freetronics/WiFiShield/README.markdown

Freetronics WiFi Shield

PCB fab stackup: 2-layer FR-4, 0.8mm thick. 0.8mm thickness is important to keep the waveguide impedence in the right ballpark. 

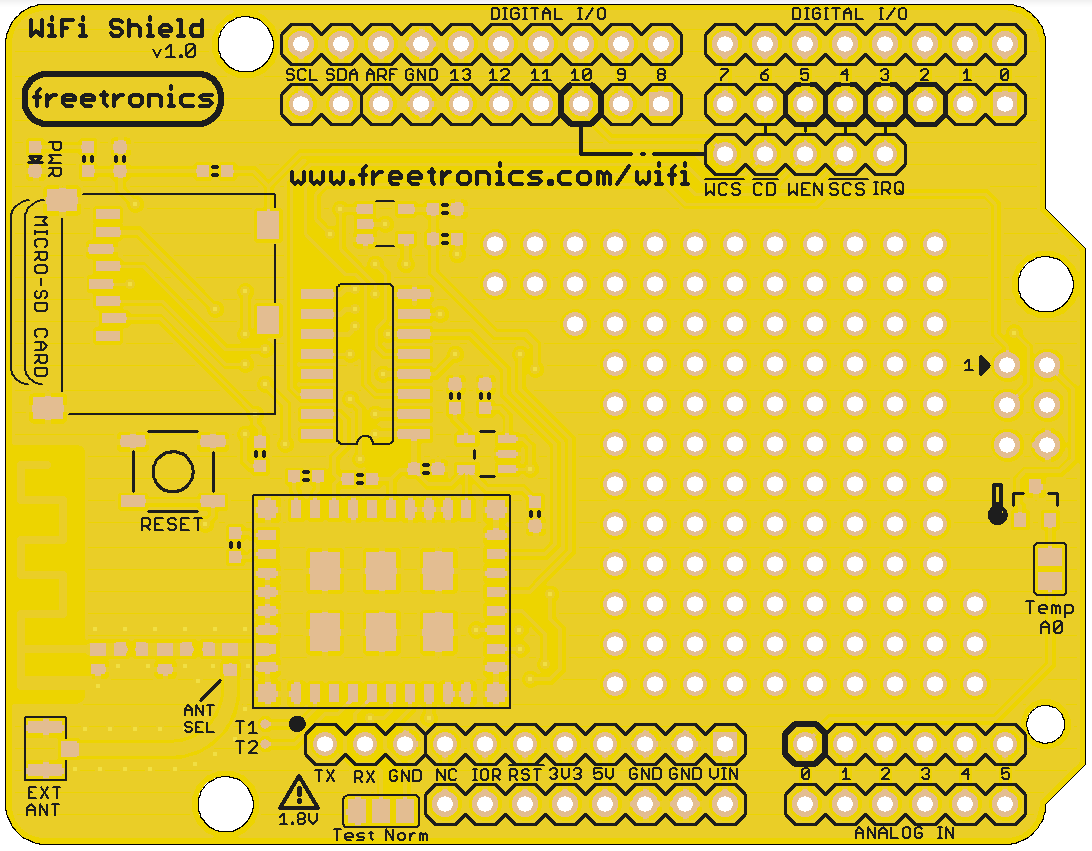
[picture p1: WiFiShield-preview.png]
