freetronics/WiFiShield/WiFiShield-schematic.pdf

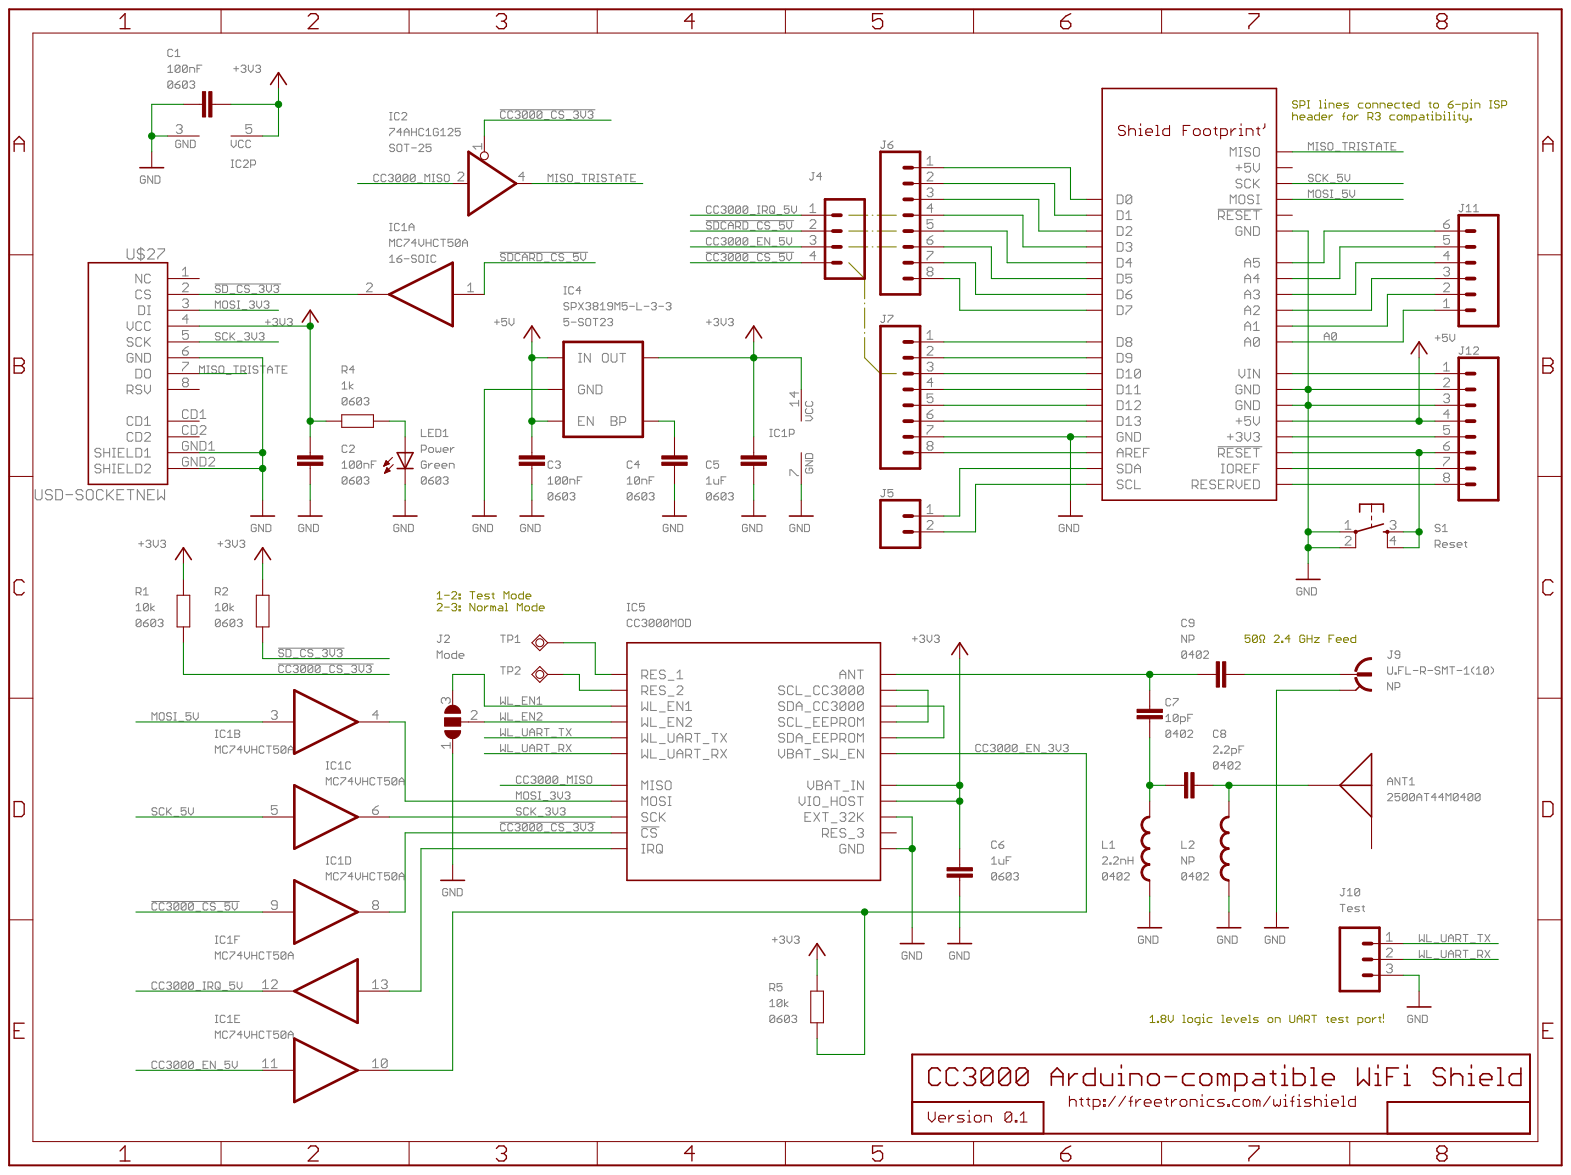
[picture p2: page 1]
