freetronics/WiFiShield/WiFiShield.brd

## EAGLE design WiFiShield.brd (2014-09-10)

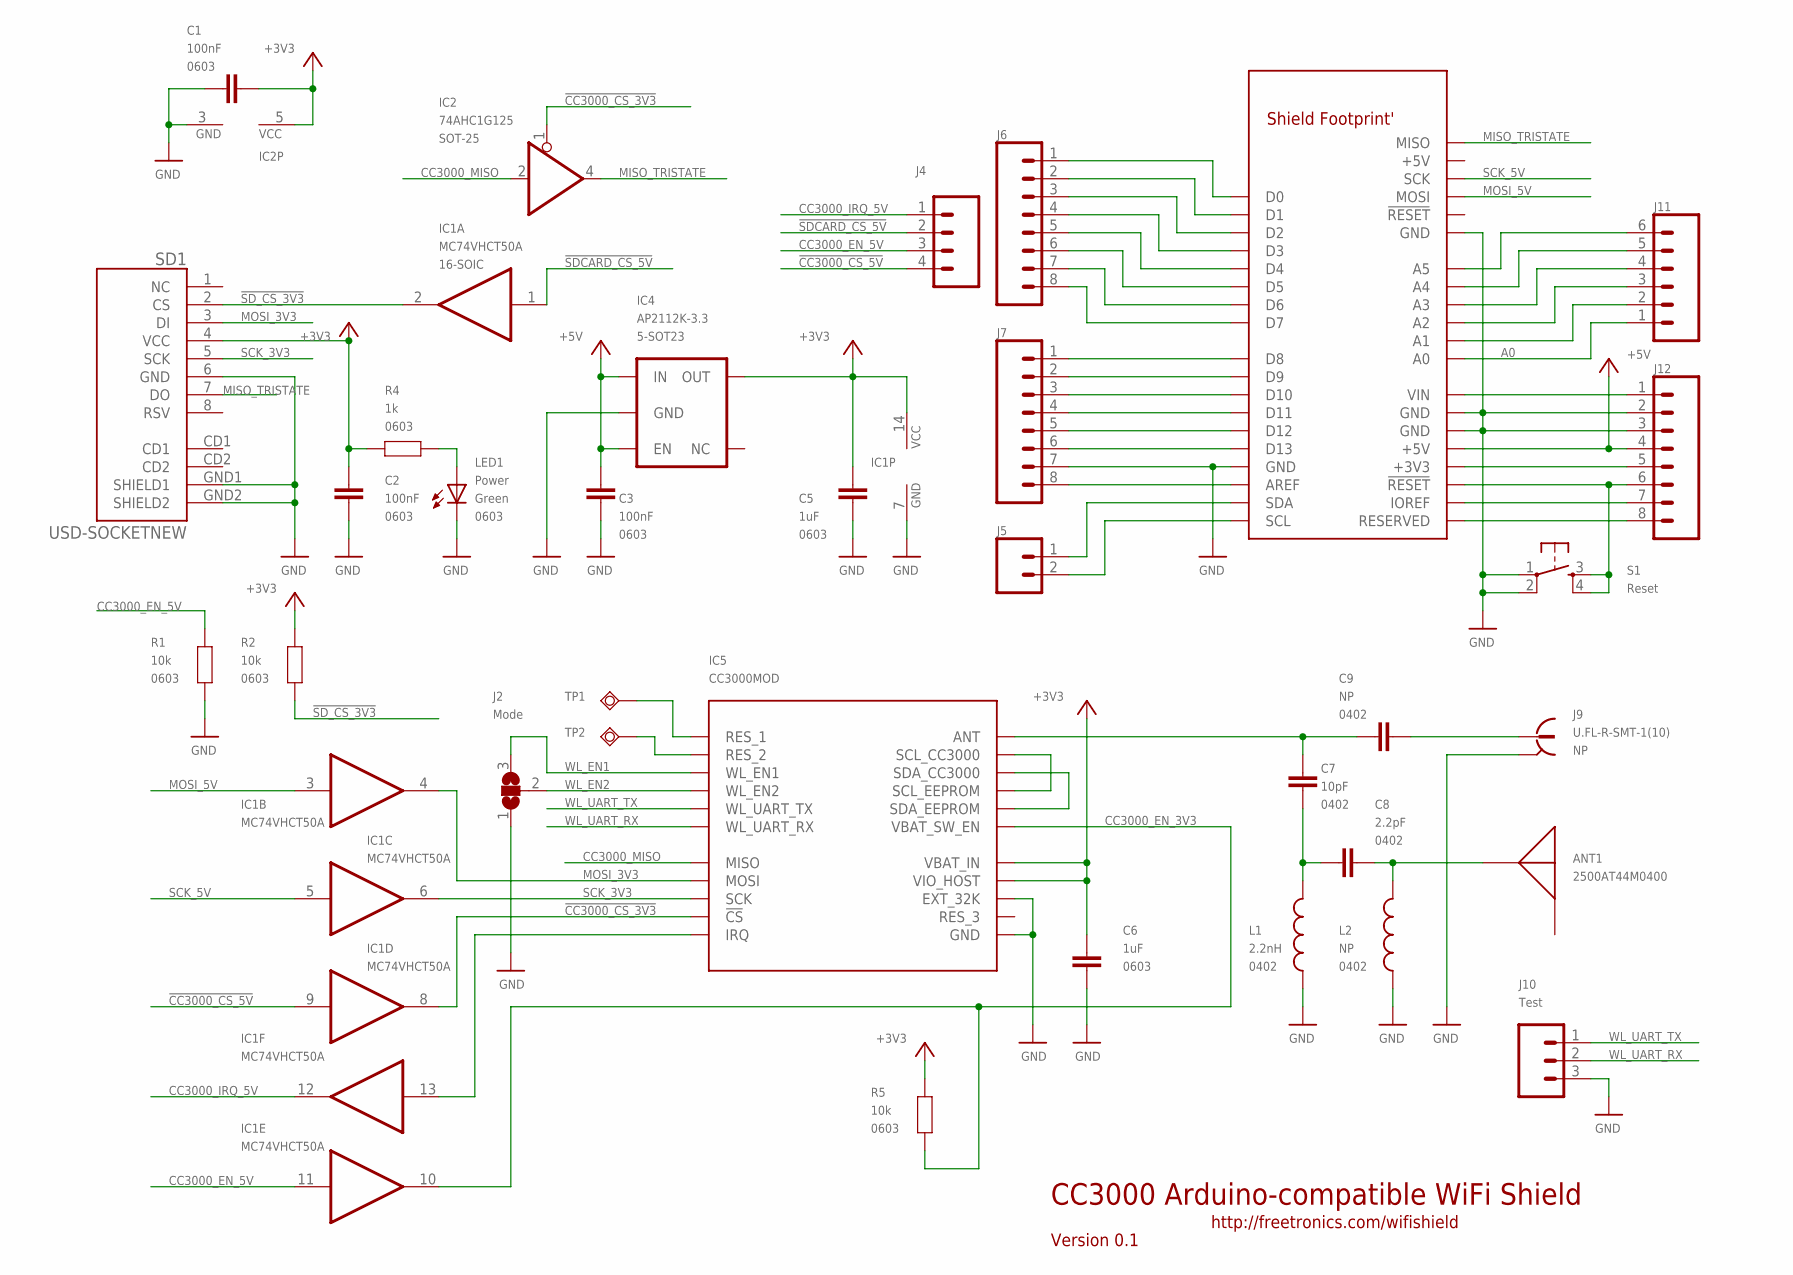
[picture p3: schematic WiFiShield.sch]

Parts:
ANT1: 2500AT44M0400
C1, C2, C3: 100nF; 0603
C5, C6: 1uF; 0603
C7: 10pF; C0402
C8: 2.2pF; C0402
C9: NP; C0402
IC1: MC74VHCT50A; SO14
IC2: 74AHC1G125; SOT23-5
IC4: AP2112K-3.3; SOT23-5
IC5: CC3000MOD; CC3000
J2: Mode; SJ_2
J4: M04PTH; 1X04
J5: M02PTH; 1X02
J6, J7, J12: M08STD; 1X08
J8: ARDUINO-SHIELD_R3; ARDUINO-SHIELD_R3_NOHOLES
J9: U.FL-R-SMT-1(10); UFL
J10: Test; 1X03
J11: M06SIP; 1X06
L1: 2.2nH; C0402
L2: NP; C0402
LED1: Power; LED-0603
R1, R2, R5: 10k; 0603
R4: 1k; 0603
S1: Reset; TACTILE_SWITCH_SMD
SD1: USD-SOCKETNEW; MICRO-SD-SOCKET-PP
TP1: R1; TP06R
TP2: R2; TP06R

Connections:
!CC3000_CS_3V3: IC1.8 (O), IC2.1 (OE), IC5.12 (!CS)
!CC3000_CS_5V: IC1.9 (I), J4.4
!SDCARD_CS_5V: IC1.1 (I), J4.2
!SD_CS_3V3: IC1.2 (O), R2.2, SD1.2 (CS)
+3V3: C1.2, C2.1, C5.1, C6.2, IC1.14 (VCC), IC2.5 (VCC), IC4.5 (OUT), IC5.19 (VBAT_IN), IC5.23 (VIO_HOST), R2.1, R4.2, R5.1, SD1.4 (VCC)
+5V: C3.2, IC4.1 (IN), IC4.3 (EN), J8.+5V, J12.4
A0: J8.A0, J11.1
CC3000_EN_3V3: IC1.10 (O), IC5.26 (VBAT_SW_EN), R5.2
CC3000_EN_5V: IC1.11 (I), J4.3, R1.1
CC3000_IRQ_5V: IC1.12 (O), J4.1
CC3000_MISO: IC2.2 (I), IC5.13 (MISO)
GND: C1.1, C2.2, C3.1, C5.2, C6.1, IC1.7 (GND), IC2.3 (GND), IC4.2 (GND), IC5.1 (GND), IC5.9 (GND), IC5.10 (GND), IC5.11 (GND), IC5.16 (GND), IC5.18 (GND), IC5.20 (GND), IC5.21 (EXT_32K), IC5.22 (GND), IC5.25 (GND), IC5.31 (GND), IC5.32 (GND), IC5.33 (GND), IC5.34 (GND), IC5.36 (GND), IC5.37 (GND), IC5.38 (GND), IC5.39 (GND), IC5.40 (GND), IC5.41 (GND), IC5.42 (GND), IC5.43 (GND), IC5.44 (GND), IC5.45 (GND), IC5.46 (GND), J2.1, J7.7, J8.GND, J8.GND@0 (GND), J8.GND@1 (GND), J8.GND@2 (GND), J9.GND, J9.GND@1 (GND), J10.3, J12.2, J12.3, L1.2, L2.2, LED1.C, R1.2, S1.1, S1.2, SD1.6 (GND), SD1.GND1 (SHIELD1), SD1.GND2 (SHIELD2)
IOREF: J8.IOREF, J12.7
MISO_TRISTATE: IC2.4 (O), J8.MISO, SD1.7 (DO)
MOSI_3V3: IC1.4 (O), IC5.15 (MOSI), SD1.3 (DI)
MOSI_5V: IC1.3 (I), J8.MOSI
unnamed: IC5.27 (SDA_EEPROM), IC5.28 (SDA_CC3000)
unnamed: IC5.29 (SCL_EEPROM), IC5.30 (SCL_CC3000)
unnamed: LED1.A, R4.1
unnamed: C7.2, C9.2, IC5.35 (ANT)
unnamed: IC5.4 (RES_2), TP2.TP
unnamed: IC5.2 (RES_1), TP1.TP
unnamed: C9.1, J9.SIG
unnamed: IC1.13 (I), IC5.14 (IRQ)
unnamed: J8.A1, J11.2
unnamed: J8.A2, J11.3
unnamed: J8.A3, J11.4
unnamed: J8.A4, J11.5
unnamed: J8.A5, J11.6
unnamed: J8.RESERVED, J12.8
unnamed: J8.VIN, J12.1
unnamed: J8.3V3 (+3V3), J12.5
unnamed: J8.!RESET, J12.6, S1.3, S1.4
unnamed: J6.1, J8.D0
unnamed: J6.2, J8.D1
unnamed: J6.3, J8.D2
unnamed: J6.4, J8.D3
unnamed: J6.5, J8.D4
unnamed: C7.1, C8.2, L1.1
unnamed: ANT1.P$1, C8.1, L2.1
unnamed: J6.6, J8.D5
unnamed: J6.7, J8.D6
unnamed: J6.8, J8.D7
unnamed: J5.1, J8.SDA
unnamed: J7.8, J8.AREF
unnamed: J7.6, J8.D13
unnamed: J7.5, J8.D12
unnamed: J5.2, J8.SCL
unnamed: J7.1, J8.D8
unnamed: J7.2, J8.D9
unnamed: J7.3, J8.D10
unnamed: J7.4, J8.D11
SCK_3V3: IC1.6 (O), IC5.17 (SCK), SD1.5 (SCK)
SCK_5V: IC1.5 (I), J8.SCK
WL_EN1: IC5.7 (WL_EN1), J2.3
WL_EN2: IC5.5 (WL_EN2), J2.2
WL_UART_RX: IC5.8 (WL_UART_RX), J10.2
WL_UART_TX: IC5.6 (WL_UART_TX), J10.1

Notes on the sheet:
CC3000 Arduino-compatible WiFi Shield
Version 0.1
http://freetronics.com/wifishield

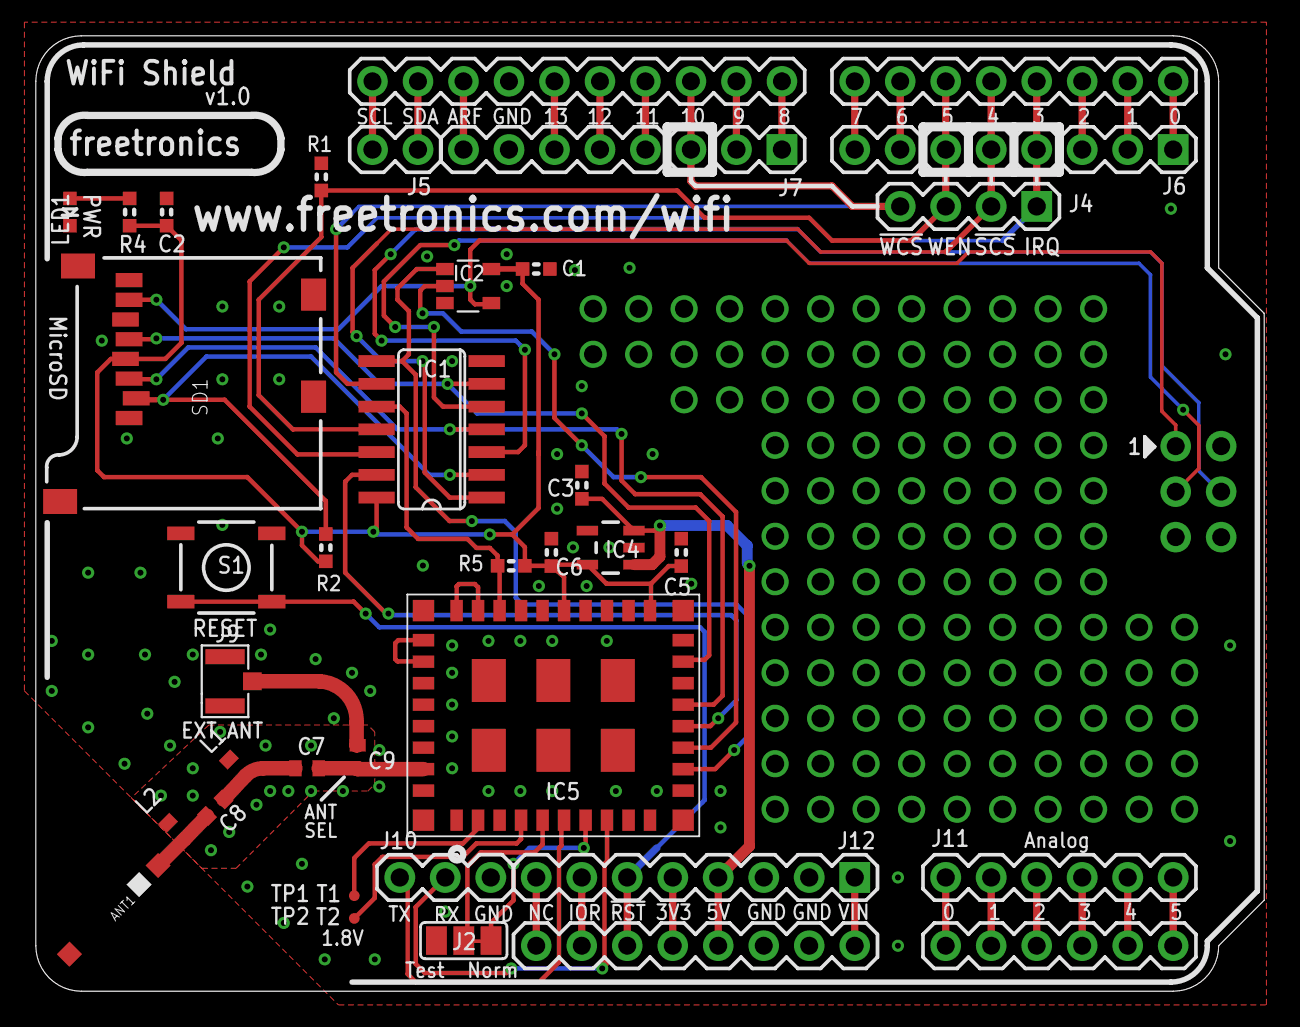
[picture p4: board WiFiShield.brd from above]

Board: 2 copper layers, 68.6 x 53.3 mm, 34 parts (0 on the bottom side), 58 nets.
