freetronics/WiFiShield/(commit log)

2013-10-12 added initial prototype design
    [WiFiShield.GBL, WiFiShield.GBO, WiFiShield.GBS, WiFiShield.GKO, WiFiShield.GTL, WiFiShield.GTO, WiFiShield.GTP, WiFiShield.GTS]
2014-04-10 Added tristate buffer on MISO to fix CC3000 SPI bug, some minor tweaks, pull-ups added on nCS lines and CC3000 enable, silkscreen label tweaks.
    [WiFiShield.brd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]
2014-04-10 regenerated images and gerbers
2014-07-08 Swap adafruit microsd slot for (very similar) freetronics library footprint, remove sometimes-problematic CD line
    [WiFiShield.brd, WiFiShield.sch]
2014-07-08 Swap 4050 buffer for MC74VHCT50A (stocked part, used on FTOLED.)
    [WiFiShield.brd, WiFiShield.sch]
2014-07-09 Fixups for MC74VHCT
    [WiFiShield.brd, WiFiShield.sch]
2014-07-09 Remove temp sensor
    [WiFiShield.GBL, WiFiShield.GBO, WiFiShield.GBS, WiFiShield.GKO, WiFiShield.GTL, WiFiShield.GTO, WiFiShield.GTP, WiFiShield.GTS]
2014-07-09 Add silkscreen border
    [WiFiShield.brd, WiFiShield.sch]
2014-07-09 Update breakout/silkscreen to match 7f99dbe3f
    [WiFiShield.brd]
2014-07-11 Additional rear silkscreen
    [WiFiShield.brd]
2014-07-24 Switch to chip antenna, final pre-prototype design review
    [WiFiShield.brd, WiFiShield.sch]
2014-07-24 Minor cleanup
    [WiFiShield.brd]
2014-08-11 Replace accidentally deleted wire
    [WiFiShield.brd, WiFiShield.sch]
2014-08-11 Update schematic PDF
    [WiFiShield.sch]
2014-09-10 Juggle antenna routing a bit
    [WiFiShield.brd, WiFiShield.sch]
2014-09-10 Swap R1 to be pulldown on enable
    [WiFiShield.brd, WiFiShield.sch]
2014-09-10 Increase pad restring, move some traces around
    [WiFiShield.brd]
2014-09-10 Swap SPX3819 LDO for AP2112K-3.3
    [WiFiShield.brd, WiFiShield.sch]
