freetronics/WiFiShield/(notices)

Notices in the files:
WiFiShield.brd:
(C) 2014 Freetronics Pty Ltd
Licensed under TAPR
Open Hardware License
